seanconway/ble-actuator-board/bom.csv

Reference | Qty | Value | Comment | MFR Part # | LCSC Part # | Datasheet | Footprint | Package | Rating | Tolerance | Type | DNP | Notes
BZ1 | 1 | Buzzer |  | KLJ-1230 | C201042 | https://jlcpcb.com/api/file/downloadByFileSystemAccessId/8588901511309512704 | imports:BUZ-SMD_L12.0-W12.0 | 12x12x3mm SMD
C1,C6,C7,C10,C12,C15,C16 | 7 | 10uF | 10uF 25V X5R 20% 0603 | CL10A106MA8NRNC | C96446 | https://jlcpcb.com/api/file/downloadByFileSystemAccessId/8568525238768373760 | Capacitor_SMD:C_0603_1608Metric | 0603 | 25V | 20% | X5R |  | 25V chosen so buck outputs keep >=4uF at 3V DC bias; C7/C15/C16 need 25V
C2,C5,C9,C11,C13,C17 | 6 | 100nF | 100nF 16V X7R 10% 0402 | CL05B104KO5NNNC | C1525 | https://jlcpcb.com/api/file/downloadByFileSystemAccessId/8579707269996871680 | Capacitor_SMD:C_0402_1005Metric | 0402 | 16V | 10% | X7R |  | C17 is on board at the U4 pads (Hall sensor supply)
C3,C8 | 2 | 1uF | 1uF 50V X7R 10% 0603 | CL10B105KB8NQNC | C5199872 | https://jlcpcb.com/api/file/downloadByFileSystemAccessId/8590445429520838656 | Capacitor_SMD:C_0603_1608Metric | 0603 | 50V | 10% | X7R |  | On VBUS / VBUSOUT; spec >=10V
C4 | 1 | 2.2uF | 2.2uF 16V X5R 10% 0603 | CL10A225KO8NNNC | C23630 | https://jlcpcb.com/api/file/downloadByFileSystemAccessId/8579707132658442240 | Capacitor_SMD:C_0603_1608Metric | 0603 | 16V | 10% | X5R |  | VBAT decoupling at U2.19
C14 | 1 | 2.2nF | 2.2nF 50V C0G 5% 0402 | GRM1555C1H222JA01D | C385029 | https://jlc-prod-smt.oss-eu-central-1.aliyuncs.com/smtDataManualFile/8589856124427411456-C385029.pdf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 | Capacitor_SMD:C_0402_1005Metric | 0402 | 50V | 5% | C0G/NP0 |  | TINRUSH timing cap; C0G required for stable timing
D1 | 1 | D_Zener |  | LTVS16H12T5G | C172439 | https://jlcpcb.com/api/file/downloadByFileSystemAccessId/8588901181775360000 | imports:DFN1610-2L_L1.6-W1.0-P1.22 | DFN1610-2L
D2,D3 | 2 | D_TVS |  | ESD9B5.0ST5G | C111566 | https://jlcpcb.com/api/file/downloadByFileSystemAccessId/8588881714542759936 | Diode_SMD:D_SOD-923 | SOD-923
D4 | 1 | LED_ABGR |  | P4-1204RGBWS2-1.5T-A | C2827295 | https://jlcpcb.com/api/file/downloadByFileSystemAccessId/8588944082340732928 | imports:LED-SMD_4P-L3.2-W1.5_P4-1204RGBWS2-1.5T-A | SMD-4P 3.2x1.0mm side-view |  |  |  |  | Common-anode RGB, side-emitting; pin 1 G-, 2 B-, 3 R-, 4 anode
J1 | 1 | USB_C_Receptacle_PowerOnly_6P |  | UJC-H-G-SMT-2-P6-TR | C45343229 | https://www.sameskydevices.com/product/resource/ujc-h-g-smt-2-p6-tr.pdf | Connector_USB:USB_C_Receptacle_GCT_USB4125-xx-x-0190_6P_TopMnt_Horizontal | USB-C 6P SMT + 4 THT shell slots
J2 | 1 | Battery |  | S2B-PH-SM4-TB(LF)(SN) | C295747 | https://jlcpcb.com/api/file/downloadByFileSystemAccessId/8587740317575483392 | Connector_JST:JST_PH_S2B-PH-SM4-TB_1x02-1MP_P2.00mm_Horizontal | JST-PH 2P SMD right-angle
L1,L2 | 2 | 2.2uH |  | WIP201610S-2R2ML | C964111 | https://jlcpcb.com/api/file/downloadByFileSystemAccessId/8603030027538231296 | imports:L_Inpaq_WIP201610S_2.0x1.6mm | 2016 (0806)
M1 | 1 | Motor_DC |  | IND-GM-609-699 | - | https://www.ineedmotors.com/Content/upload/pdf/202316849/rd0845e53-b30d-4560-b36b-546d41732662.pdf | Connector_Wire:SolderWire-0.1sqmm_1x02_P3.6mm_D0.4mm_OD1mm | Off-board, 2 wire pads |  |  |  | DNP | Off-board gearmotor, hand-soldered to wire pads after assembly
R1,R4,R5,R6 | 4 | 10k | 10k 1% 1/16W 0402 | 0402WGF1002TCE | C25744 | https://jlcpcb.com/api/file/downloadByFileSystemAccessId/8556212101498380288 | Resistor_SMD:R_0402_1005Metric | 0402 | 1/16W | 1% | Thick film
R2,R10 | 2 | 0R | 0R jumper 0603 | 0603WAF0000T5E | C21189 | https://jlcpcb.com/api/file/downloadByFileSystemAccessId/8756450222375747584 | Resistor_SMD:R_0603_1608Metric | 0603 | 1A | Jumper | Thick film |  | VBAT current-measurement link; 0603 per spec
R3 | 1 | 150k | 150k 1% 1/10W 0603 | 0603WAF1503T5E | C22807 | https://jlc-prod-smt.oss-eu-central-1.aliyuncs.com/smtDataManualFile/8579706125421502464-C22807.pdf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 | Resistor_SMD:R_0603_1608Metric | 0603 | 1/10W | 1% | Thick film |  | VSET2 -> BUCK2 = 3.0V at power-up; must be <=5% tolerance
R7 | 1 | 5.1k | 5.1k 1% 1/10W 0603 | 0603WAF5101T5E | C23186 | https://jlcpcb.com/api/file/downloadByFileSystemAccessId/8579706277024620544 | Resistor_SMD:R_0603_1608Metric | 0603 | 1/10W | 1% | Thick film |  | R_IPROPI: ITRIP ~40mA (High gain); swapped during bench calibration
R8 | 1 | 100k | 100k 1% 1/16W 0402 | 0402WGF1003TCE | C25741 | https://jlcpcb.com/api/file/downloadByFileSystemAccessId/8579705919464263680 | Resistor_SMD:R_0402_1005Metric | 0402 | 1/16W | 1% | Thick film |  | VREF divider, 1% required
R9 | 1 | 200k | 200k 1% 1/16W 0402 | 0402WGF2003TCE | C25764 | https://jlcpcb.com/api/file/downloadByFileSystemAccessId/8579705982873886720 | Resistor_SMD:R_0402_1005Metric | 0402 | 1/16W | 1% | Thick film |  | VREF divider, 1% required
R11 | 1 | 1k | 1k 1% 1/16W 0402 | 0402WGF1001TCE | C11702 | https://jlc-prod-smt.oss-eu-central-1.aliyuncs.com/smtDataManualFile/8579705924159586304-C11702.pdf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 | Resistor_SMD:R_0402_1005Metric | 0402 | 1/16W | 1% | Thick film
R12 | 1 | 100R | 100R 1% 1/16W 0402 | 0402WGF1000TCE | C25076 | https://jlc-prod-smt.oss-eu-central-1.aliyuncs.com/smtDataManualFile/8579705907476807680-C25076.pdf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 | Resistor_SMD:R_0402_1005Metric | 0402 | 1/16W | 1% | Thick film
TH1 | 1 | Thermistor_NTC |  | NCP18XH103F03RB | C13564 | https://jlcpcb.com/api/file/downloadByFileSystemAccessId/8588899519785918464 | Resistor_SMD:R_0603_1608Metric | 0603
U1 | 1 | MDBT50Q_1 |  | MDBT50Q-P1MV2 | C5119772 |  | RF_Module:Raytac_MDBT50Q | Module 10.5x15.5mm
U2 | 1 | nPM1300-QEXX |  | nPM1300-QEAA-R | C7466043 | https://jlcpcb.com/api/file/downloadByFileSystemAccessId/8716057988873592832 | Package_DFN_QFN:QFN-32-1EP_5x5mm_P0.5mm_EP3.6x3.6mm_ThermalVias | QFN-32 5x5mm
U3 | 1 | DRV8213RTER |  | DRV8213RTER | C31829946 | https://www.ti.com.cn/cn/lit/ds/symlink/drv8213.pdf | imports:RTE0016C-MFG | WQFN-16 3x3mm (RTE)
U4 | 1 | DRV5032FBLPGM |  | DRV5032FBLPGM | C2862715 | https://www.ti.com/cn/lit/gpn/drv5032 | Connector_Wire:SolderWire-0.1sqmm_1x03_P3.6mm_D0.4mm_OD1mm | TO-92 off-board, 3 wire pads |  |  |  | DNP | Off-board Hall switch, hand-soldered to wire pads after assembly
