seanconway/ble-actuator-board/kicad/ble-actuator-board.kicad_pcb

## KiCad design kicad/ble-actuator-board.kicad_pcb (2026-10-22)

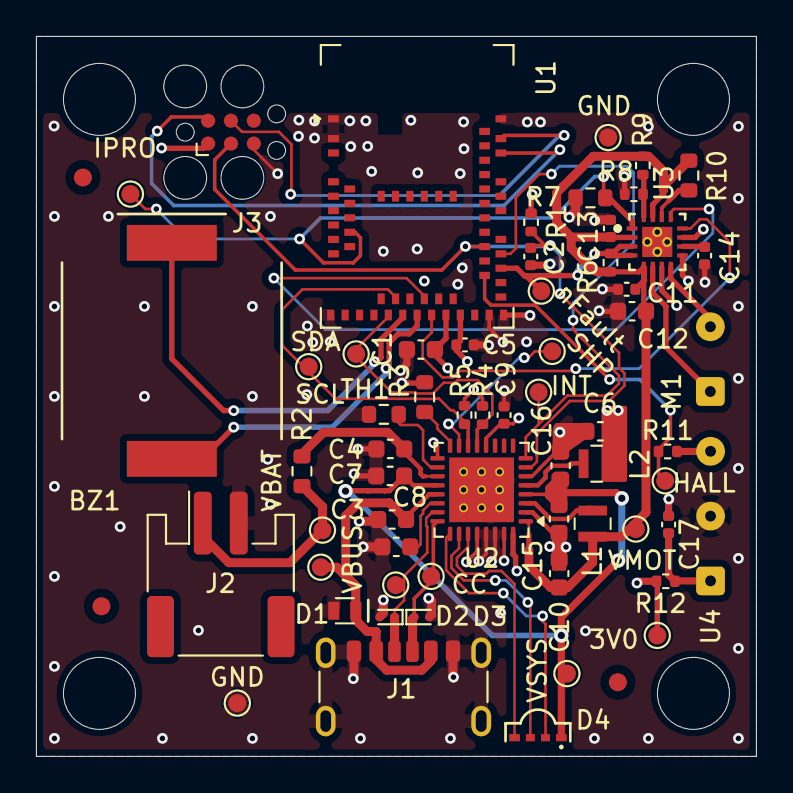
[picture p1: board ble-actuator-board.kicad_pcb from above]

Board: 4 copper layers, 40.0 x 40.0 mm, 61 parts (0 on the bottom side), 38 nets.

Parts:
3V0: 3V0; TestPoint_Pad_D1.0mm
BZ1: KLJ-1230; BUZ-SMD_L12.0-W12.0
C1, C6, C7, C10, C12, C15, C16: 10uF; C_0603_1608Metric
C2, C5, C9, C11, C13, C17: 100nF; C_0402_1005Metric
C3, C8: 1uF; C_0603_1608Metric
C4: 2.2uF; C_0603_1608Metric
C14: 2.2nF; C_0402_1005Metric
CC: CC2; TestPoint_Pad_D1.0mm
D1: LTVS16H12T5G; DFN1610-2L_L1.6-W1.0-P1.22
D2, D3: ESD9B5.0ST5G; D_SOD-923
D4: NH-B1515RGBA-GF; LED-SMD_4P-L3.2-W1.5_P4-1204RGBWS2-1.5T-A
GND: GND; TestPoint_Pad_D1.0mm
GND#2: GND; TestPoint_Pad_D1.0mm
HALL: HALL_SENSE; TestPoint_Pad_D1.0mm
INT: PMIC_INT; TestPoint_Pad_D1.0mm
IPRO: MOT_IPROPI; TestPoint_Pad_D1.0mm
J1: UJC-H-G-SMT-2-P6-TR; USB_C_Receptacle_GCT_USB4125-xx-x-0190_6P_TopMnt_Horizontal
J2: S2B-PH-SM4-TB; JST_PH_S2B-PH-SM4-TB_1x02-1MP_P2.00mm_Horizontal
J3: Conn_ARM_SWD_TagConnect_TC2030; Tag-Connect_TC2030-IDC-FP_2x03_P1.27mm_Vertical
L1, L2: 2.2uH; L_Inpaq_WIP201610S_2.0x1.6mm
M1: IND-GM-609-699; SolderWire-0.1sqmm_1x02_P3.6mm_D0.4mm_OD1mm
R1, R4, R5, R6: 10k; R_0402_1005Metric
R2, R10: 0R; R_0603_1608Metric
R3: 150k; R_0603_1608Metric
R7: 5.1k; R_0603_1608Metric
R8: 100k; R_0402_1005Metric
R9: 200k; R_0402_1005Metric
R11: 1k; R_0402_1005Metric
R12: 100R; R_0402_1005Metric
SCL: SCL; TestPoint_Pad_D1.0mm
SDA: SDA; TestPoint_Pad_D1.0mm
SHP: SHPHLD; TestPoint_Pad_D1.0mm
TH1: NCP18XH103F03RB; R_0603_1608Metric
TP9: CC1; TestPoint_Pad_D1.0mm
U1: MDBT50Q-P1MV2; Raytac_MDBT50Q
U2: nPM1300-QEAA-R; QFN-32-1EP_5x5mm_P0.5mm_EP3.6x3.6mm_ThermalVias
U3: DRV8213RTER; RTE0016C-MFG
U4: DRV5032FBLPGM; SolderWire-0.1sqmm_1x03_P3.6mm_D0.4mm_OD1mm
VBAT: VBAT; TestPoint_Pad_D1.0mm
VBUS: VBUS; TestPoint_Pad_D1.0mm
VMOT: VMOT; TestPoint_Pad_D1.0mm
VSYS: VSYS; TestPoint_Pad_D1.0mm
nFault: MOT_nFAULT; TestPoint_Pad_D1.0mm

Connections:
/3V0: 3V0.1 (1_1), C1.1, C5.1, C6.1, C9.1, J3.1 (VCC), L2.1, R1.2, R4.2, R5.2, R12.2, U1.28 (VDD), U1.30 (VDDH), U2.12 (VDDIO), U2.32 (VOUT2)
/BUZ_A: BZ1.1 (+), U1.22 (P0.06)
/BUZ_B: BZ1.2 (-), U1.24 (P0.08)
/HALL_SENSE: HALL.1 (1_1), R11.1, U1.36 (P0.14)
/MOT_IN1: U1.25 (P1.08), U3.13 (IN1)
/MOT_IN2: U1.26 (P1.09), U3.12 (IN2)
/MOT_IPROPI: IPRO.1 (1_1), R7.1, U1.11 (P0.02/AIN0), U3.1 (IPROPI)
/MOT_nFAULT: R6.2, U1.37 (P0.13), U3.3 (STALL_N), U3.4 (FAULT_N), nFault.1 (1_1)
/PMIC_INT: INT.1 (1_1), U1.39 (P0.15), U2.8 (GPIO1)
/SCL: R5.1, SCL.1 (1_1), U1.21 (P0.05/AIN3), U2.14 (SCL)
/SDA: R4.1, SDA.1 (1_1), U1.20 (P0.04/AIN2), U2.13 (SDA)
/VBAT: C4.1, R2.1, U2.19 (VBAT)
/VBUS: C3.2, D1.1 (K), J1.A9 (VBUS), J1.B9 (VBUS), U2.21 (VBUS), VBUS.1 (1_1)
/VMOT: C10.1, C11.2, C12.2, C13.2, L1.1, R6.1, R9.2, R10.1, U2.1 (VOUT1), U3.2 (VCC), U3.5 (VM), U3.15 (IMODE), VMOT.1 (1_1)
/VSYS: C7.2, C15.2, C16.1, D4.4 (A), U2.4 (PVDD), U2.20 (VSYS), VSYS.1 (1_1)
/nRESET: C2.1, J3.3 (~RESET), R1.1, U1.40 (P0.18/RESET), U2.7 (GPIO0)
GND: C1.2, C2.2, C3.1, C4.2, C5.2, C6.2, C7.1, C8.2, C9.2, C10.2, C11.1, C12.1, C13.1, C14.1, C15.1, C16.2, C17.1, D1.2 (A), D2.2 (A2), D3.2 (A2), GND.1 (1_1), GND#2.1 (1_1), J1.A12 (GND), J1.B12 (GND), J1.SH (SHIELD), J2.2 (-), J3.5 (GND), R3.1, R7.2, R8.2, TH1.2, U1.1 (GND@1), U1.2 (GND@2), U1.15 (GND@15), U1.32 (VBUS), U1.33 (GND@33), U1.55 (GND@55), U2.2 (PVSS1), U2.6 (PVSS2), U2.17 (VSET1), U2.28 (LSIN1/VINLDO1), U2.29 (LSOUT1/VOUTLDO1), U2.30 (LSIN2/VINLDO2), U2.31 (LSOUT2/VOUTLDO2), U2.33 (AVSS), U3.7 (PGND), U3.9 (GND), U3.11 (SMODE), U3.17 (Thermal_Pad), U4.2 (GND)
unnamed: D2.1 (A1), J1.A5 (CC1), TP9.1 (1_1), U2.23 (CC1)
unnamed: CC.1 (1_1), D3.1 (A1), J1.B5 (CC2), U2.24 (CC2)
unnamed: D4.2 (BK), U2.25 (LED0)
unnamed: D4.1 (GK), U2.26 (LED1)
unnamed: D4.3 (RK), U2.27 (LED2)
unnamed: J2.1 (+), R2.2, VBAT.1 (1_1)
unnamed: J3.4 (SWCLK), U1.53 (SWDCLK)
unnamed: J3.2 (SWDIO), U1.51 (SWDIO)
unnamed: M1.1 (+), U3.6 (OUT1)
unnamed: M1.2 (-), U3.8 (OUT2)
unnamed: TH1.1, U2.18 (NTC)
unnamed: SHP.1 (1_1), U2.15 (SHPHLD)
unnamed: L1.2, U2.3 (SW1)
unnamed: L2.2, U2.5 (SW2)
unnamed: C8.1, U2.22 (VBUSOUT)
unnamed: R3.2, U2.16 (VSET2)
unnamed: R10.2, U3.14 (GAINSEL)
unnamed: C14.2, U3.10 (TINRUSH)
unnamed: R8.1, R9.1, U3.16 (VREF)
unnamed: R11.2, U4.3 (OUT)
unnamed: C17.2, R12.1, U4.1 (VCC)
