seanconway/ble-actuator-board/(commit log)

2026-10-22 Initial commit: KiCad project, BOM, and design overview for review
    [ble-actuator-board.kicad_pcb, ble-actuator-board.kicad_sch, bom.csv]
2026-10-22 Replace README with hardware design spec, add review request, complete BOM
    - README is the hardware build spec, generalized to a pocket-sized smart-lock
    container and corrected against the KiCad project (LED part and pinout,
    USB-C footprint, PMIC footprint, L3 plane, test pad references, TH1 placement)
    - REVIEW_REQUEST.md: short design overview and prioritized review questions
    - bom.csv: footprint and package for every line; descriptions corrected to match
    the MPNs (C1-C16 tolerance, C3/C8 dielectric and voltage, C4 dielectric)
    [bom.csv]
